nukerobear/Thermal-Monitoring-System---Practicum-project/README.md

Thermal-Monitoring-System---Practicum-project
=============================================
