nukerobear/Thermal-Monitoring-System---Practicum-project/T07 Practicum Team Meeting_11_18_14.docx

T07 Practicum Team Meeting

Attendance:

Rob

Mike

Jordan

Dima

Jose

Topics:

CT- Still see saturation, at amps higher than 60.

Not as accurate at values less than 20 amps.

IR: Works and has been tested

Testing Procedure: Need to write up Test Procedure.

Actions Require:

Mike - Bake board

Dima – Download drive and get smart cable working

Rob - Dial in CT and create algorithm

Team- Testing Procedure.

Jose - Enclosure
