nukerobear/Thermal-Monitoring-System---Practicum-project/T07 Team Meeting 11_11_14.docx

T07 Team Meeting 11/11/14

Attendance:

Mike

Jose

Rob

Dima absent (notified team beforehand)

Topics:

Prototype

Next Assignment Due

Enclosure

Prototype:

- Works

Enclosure

- Jose is making autocad drawing

Actions required

Jose: continue with schematic, make Interface diagram

Mike and Rob: make block diagram

Rob: Make activity diagram

Dima: look at block, activity, and interface diagrams for submission
