nukerobear/Thermal-Monitoring-System---Practicum-project/T07 Team Meeting 11_4_14.docx

T07 Team Meeting 11/4/14

Attendance: Topics:

Mike CT-

Dima Figure out conversion factor and write code

Jose Almost functional-Just need to interface with UC

Rob Pwr Source for UC-

Hook up voltage regulator to battery supply

LCD-

Get it connected

Display temp

Action Required:

Jose- order resistors for CT

Rob-Figure out conversion factor

Dima-interface LCD and CT

Mike-Figure out power supply
