nukerobear/Thermal-Monitoring-System---Practicum-project/T07 Team Meeting 11_6_14.docx

T07 Team Meeting 11/6/14

Attendance:

Mike

Dima

Jose

Rob

Topics:

Prototype

Next Assignment Due

Enclosure

Prototype:

- Get working today
- Integrate with IR and CT

Enclosure

- Needs to be mounted vertically
- IR needs to be ½ to ¼ inch from Busbar
- Needs to clamp to Busbar

Actions required

Jose: draw schematic of enclosure based off team drawings

Mike and Dima: Interface IR and CT

Rob: start working on Block diagram Assignment
