nukerobear/Thermal-Monitoring-System---Practicum-project/T07 BOM Rev4.xlsx

T07 Bill of Materials
Name | Manufacturer/Bought From | Part NO. | cost per unit | Quatitiy | NO. ordered for project | NO. Ordered for 1 system | Part Cost per 1 system | NO. order per 1000 system | Part Cost per 100 systems
Non-contact IR thermometer | Melexis | MLX90614 | $14.95 | 1 | 1 | 1 | $14.95 | 1000 | $14950.00
Atmega328P-PU | ATMEL |  | $2.25 | 1 | 2 | 1 | $2.25 | 1000 | $2250.00
16 MHz Crystal | Arduino |  | $3.49 | 1 | 1 | 1 | $3.49 | 1000 | $3490.00
DC Power Jack Socket 2.1mm |  |  | $1.19 | 10 | 1 | 1 | $1.19 | 100 | $119.00
40 Pin 2.54.. 100" Breakable header strip |  |  | $3.29 | 10 | 1 | 1 | $3.29 | 100 | $329.00
Rectifier |  | VH848 | $15.00 | 4 | 1 | 1 | $15.00 | 250 | $3750.00
CT |  | E93779 | $15.00 | 1 | 0 | 1 | $15.00 | 1000 | $15000.00
PCB board |  |  | $29.00 | 4 | 1 | 1 | $29.00 | 250 | $7250.00
0.1 uF capacitors 0805 |  |  | $0.25 | 1 | 10 | 3 | $0.75 | 3000 | $750.00
10Kohm Resistors 0805 |  |  | $0.10 | 1 | 10 | 3 | $0.30 | 3000 | $300.00
LCD Screen ST7066 | Sparkfun | LCD-09053 | $13.95 | 1 | 0 | 1 | $13.95 | 100 | $1395.00
Clamps |  |  | $1.99 | 1 | 1 | 1 | $1.99 | 1000 | $1990.00
Voltage Regulator 7805 | Sparkfun | COM-00107 | $0.95 | 1 | 1 | 1 | $0.95 | 1000 | $950.00
Smart Cables | Sparkfun | DEV-09717 | $17.95 | 1 | 1 | 1 | $17.95 | 1000 | $17950.00
Bolts and Nuts |  |  | $2.66 | 8 | 1 | 1 | $2.66 | 1000 | $2660.00
Enclosure |  |  | $13.00 | 1 | 1 | 1 | $13.00 | 1000 | $13000.00
Battery |  |  | $2.00 | 1 | 1 | 1 | $2.00 | 1000 | $2000.00
2 ohm Resistors 10W | Parts Express | XICON | $0.64 | 1 | 5 | 5 | $3.20 | 5000 | $3200.00
10uF Capacitor | Sparkfun | COM-00523 | $0.45 | 1 | 1 | 1 | $0.45 | 1000 | $450.00
47k Resistors |  |  | $0.10 | 1 | 1 | 1 | $0.10 | 1000 | $100.00
Wiring (estimate) | Sparkfun | PRT08865 | $2.95 | 1 | 0 | 1 | $2.95 | 120 | $354.00
Solder Paste (estimate) | Sparkfun | TOL-12878 | $16.95 | 1 | 0 | 1 | $16.95 | 20 | $339.00
Potentiometer |  |  | $0.25 | 1 | 1 | 1 | $0.25 | 1000 | $250.00
Solder (estimate) | Sparkfun | TOL-09325 | $7.95 | 1 | 0 | 1 | $7.95 | 50 | $397.50
 |  |  |  |  |  | Total | $169.57 | Total | $93223.50
