nukerobear/Thermal-Monitoring-System---Practicum-project/T07 411rev 4.brd

## EAGLE design T07 411rev 4.brd (2014-12-11)

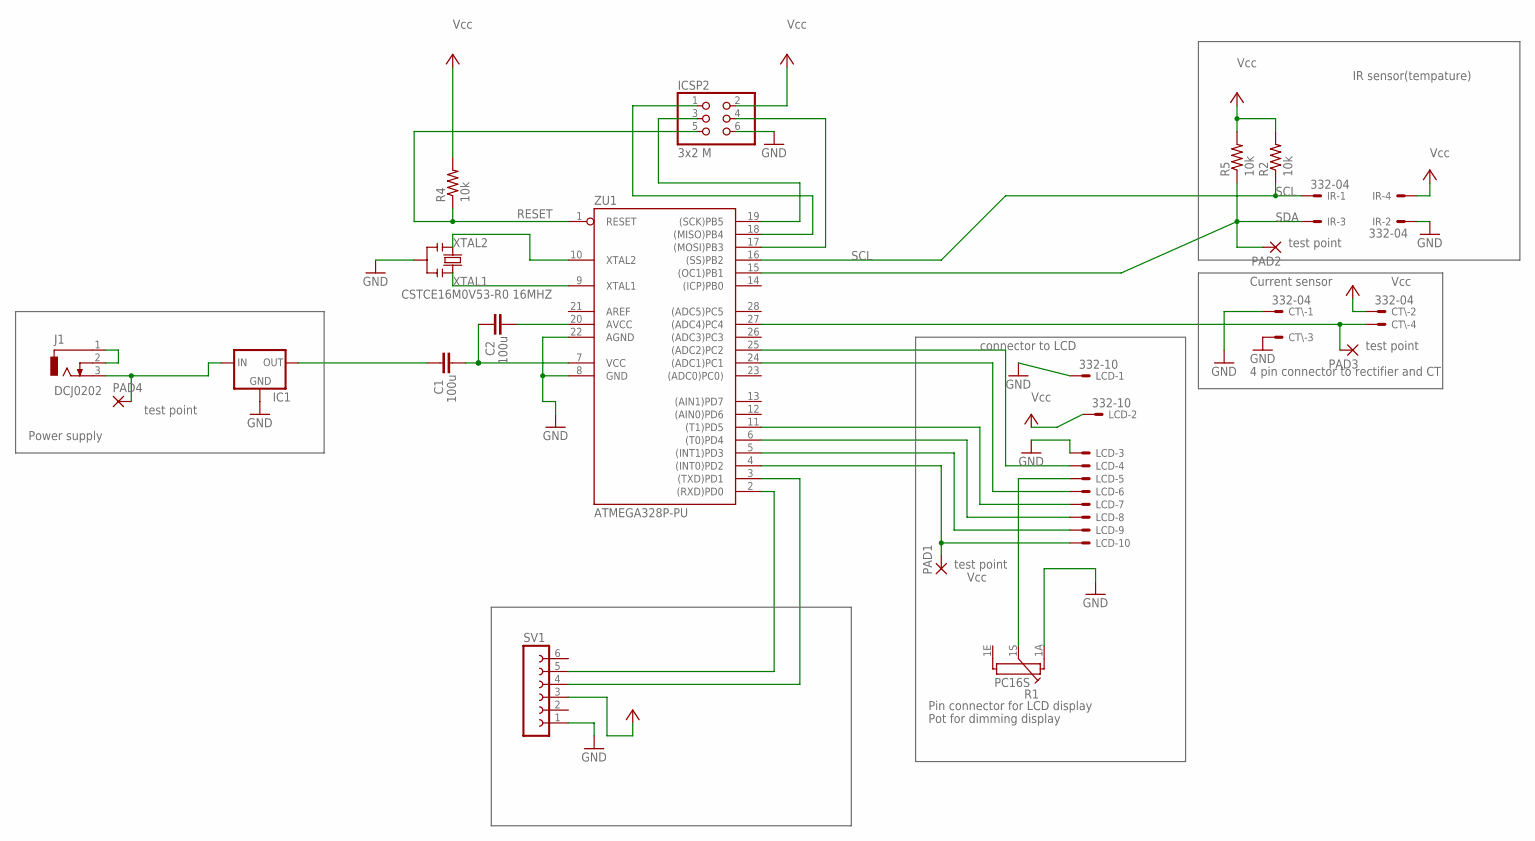
[picture p21: schematic T07 411rev 4.sch]

Parts:
C1, C2: 100u; C0603-ROUND
CT\: 332-04
IC1: 78XXL
ICSP2: 3x2 M; 2X03
IR: 332-04
J1: DCJ0202
LCD: 332-10
PAD1, PAD2, PAD3, PAD4: 1,6/0,9
R1: PC16S
R2, R4, R5: 10k; 0402-RES
SV1: FE06-1; FE06
Y3: CSTCE16M0V53-R0 16MHZ; RESONATOR
ZU1: ATMEGA328P-PU; DIL28-3

Connections:
+5V: CT\.2, ICSP2.2, IR.4, LCD.2, R2.2, R4.2, R5.2, SV1.3
GND: CT\.1, CT\.3, IC1.GND, ICSP2.6, IR.2, LCD.1, LCD.3, R1.1A, SV1.1, Y3.2, ZU1.8 (GND), ZU1.22 (AGND)
MISO1: ICSP2.1, ZU1.18 ((MISO)PB4)
MOSI1: ICSP2.4, ZU1.17 ((MOSI)PB3)
unnamed: LCD.10, PAD1.1, ZU1.4 ((INT0)PD2)
unnamed: LCD.9, ZU1.5 ((INT1)PD3)
unnamed: LCD.8, ZU1.6 ((T0)PD4)
unnamed: LCD.7, ZU1.11 ((T1)PD5)
unnamed: LCD.6, ZU1.24 ((ADC1)PC1)
unnamed: LCD.4, ZU1.25 ((ADC2)PC2)
unnamed: LCD.5, R1.1S
unnamed: C1.2, IC1.OUT
unnamed: IC1.IN, J1.3, PAD4.1
unnamed: C1.1, C2.2, ZU1.7 (VCC)
unnamed: C2.1, ZU1.20 (AVCC)
unnamed: CT\.4, PAD3.1, ZU1.27 ((ADC4)PC4)
unnamed: J1.1, J1.2
unnamed: SV1.4, ZU1.3 ((TXD)PD1)
unnamed: SV1.5, ZU1.2 ((RXD)PD0)
RESET: ICSP2.5, R4.1, ZU1.1 (RESET)
SCK1: ICSP2.3, ZU1.19 ((SCK)PB5)
SCL: IR.1, R2.1, ZU1.16 ((SS)PB2)
SDA: IR.3, PAD2.1, R5.1, ZU1.15 ((OC1)PB1)
XTAL1: Y3.3, ZU1.9 (XTAL1)
XTAL2: Y3.1, ZU1.10 (XTAL2)

Notes on the sheet:
connector to LCD
IR sensor(tempature)
Power supply
Current sensor
4 pin connector to rectifier and CT
Pin connector for LCD display
Pot for dimming display
Vcc
test point

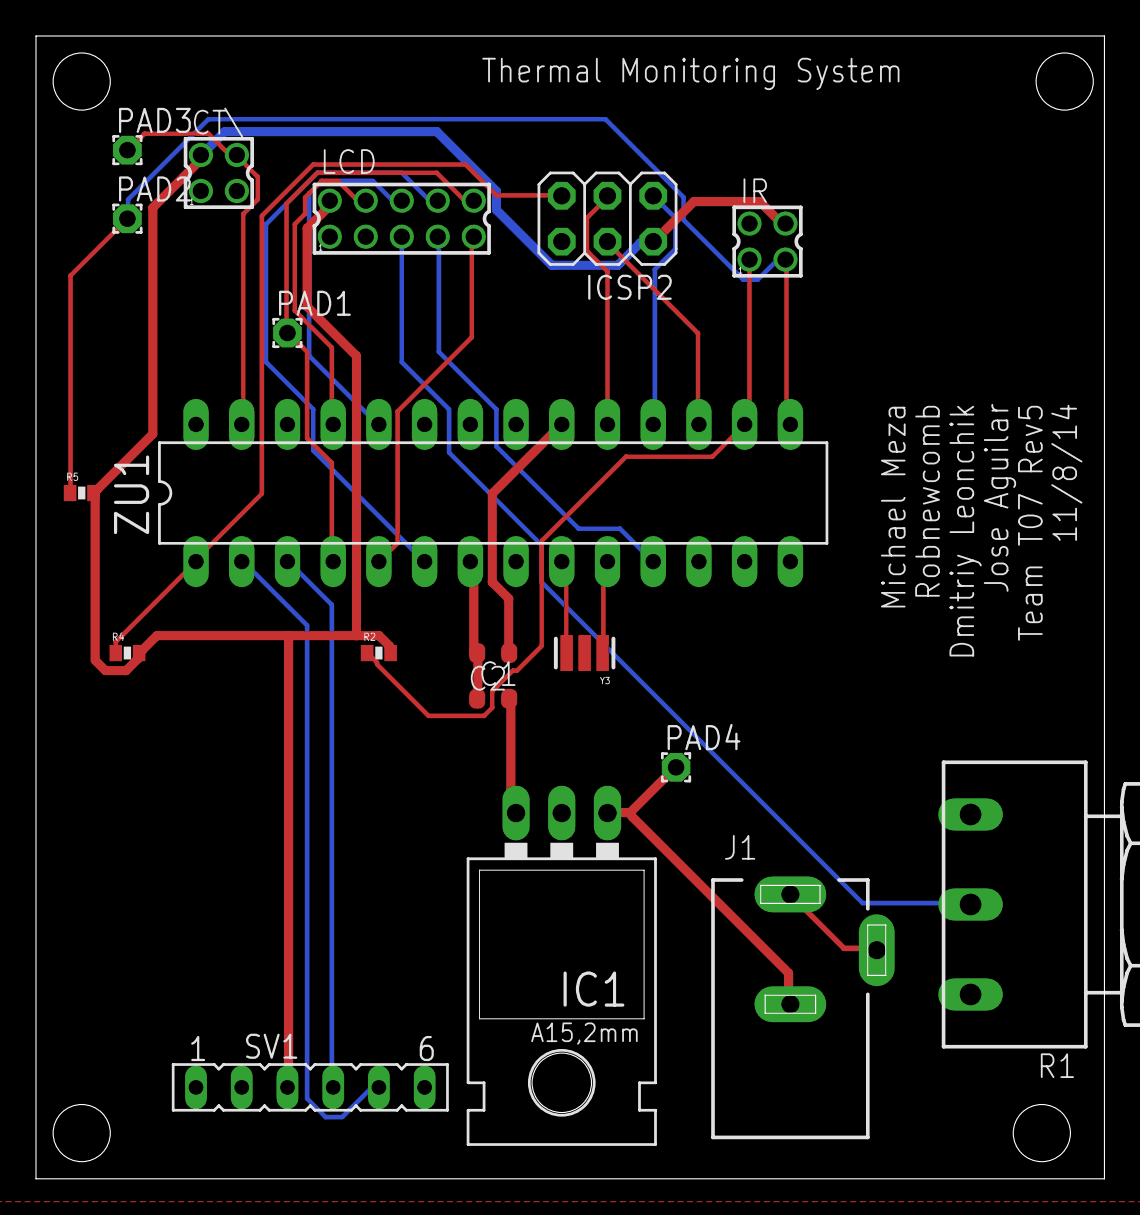
[picture p22: board T07 411rev 4.brd from above]

Board: 2 copper layers, 59.4 x 63.5 mm, 19 parts (0 on the bottom side), 25 nets.
