nukerobear/Thermal-Monitoring-System---Practicum-project/(commit log)

2014-10-29 Schematic of 411 Project
2014-10-29 Schematic of 411 Project T07
    [411 project.sch]
2014-11-05 T07 Schematic due 11/5
    [T07 411.brd, T07 411.sch]
2014-11-05 Preliminary Board Layout Due 11/5
    [T07 411.brd, T07 411.sch]
2014-11-06 T07 Preliminary Schematic Due 11/5 Rev.2
    [T07 411.brd, T07 411.sch]
2014-12-11 Final Project Documents
    [T07 BOM Rev4.xlsx]
2014-12-11 Board Layout and schematic T07
    [T07 411rev 4.brd, T07 411rev 4.sch]
